dabonetn/Swift-Internal/readme.txt

I've moved the internal modems under the main Link-232-Wifi project.

Please see here.

https://github.com/dabonetn/Link232-Wifi
