dabonetn/Swift-Internal/Eagle/SF232-Internal-128 - Ver1.3/Swiftl1.3.png

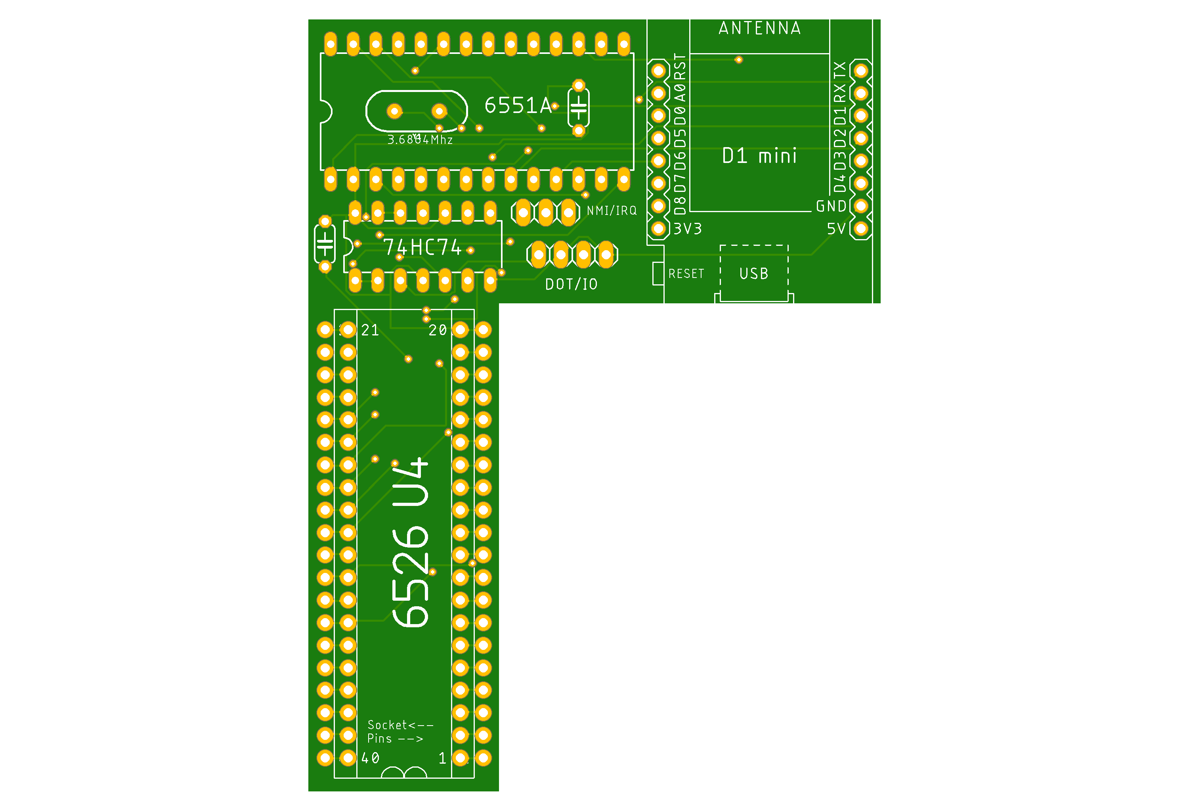
Eagle/SF232-Internal-128 - Ver1.3/Swiftl1.3.png
