dabonetn/Swift-Internal/Eagle/SF232-Internal-128 - Ver1.3/Link232-wifi.brd

## EAGLE design Eagle/SF232-Internal-128 - Ver1.3/Link232-wifi.brd (2022-05-11)

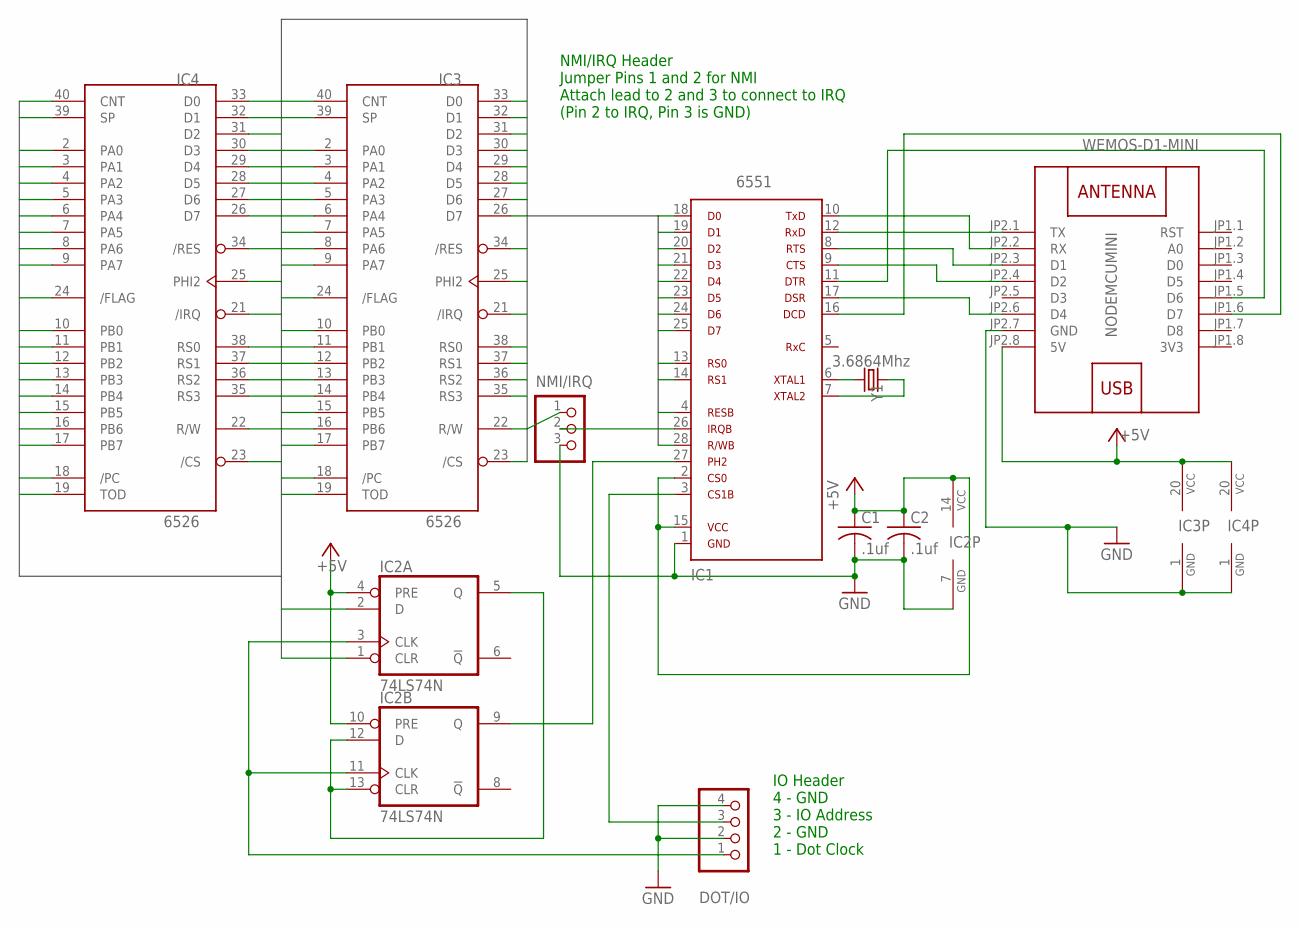
[picture p2: schematic Link232-wifi.sch]

Parts:
C1, C2: .1uf; C050-024X044
DOT/IO: PINHD-1X4; 1X04
IC1: 6551
IC2: 74LS74N; DIL14
IC3, IC4: 6526; DIP40
JP1: NMI/IRQ; 1X03
NODEMCUMINI: WEMOS-D1-MINI
Y1: 3.6864Mhz; HC49US

Connections:
3V3: NODEMCUMINI.JP1.8 (3V3)
+5V: C1.1, C2.1, IC1.2, IC1.15, IC2.4 (PRE), IC2.10 (PRE), IC2.14 (VCC), IC3.20 (VCC), IC4.20 (VCC), NODEMCUMINI.JP2.8 (5V)
/CS: IC3.23 (/CS), IC4.23 (/CS)
/FLAG: IC3.24 (/FLAG), IC4.24 (/FLAG)
/PC: IC3.18 (/PC), IC4.18 (/PC)
CNT: IC3.40 (CNT), IC4.40 (CNT)
D0: IC1.18, IC3.33 (D0), IC4.33 (D0)
D1: IC1.19, IC3.32 (D1), IC4.32 (D1)
D2: IC1.20, IC3.31 (D2), IC4.31 (D2)
D3: IC1.21, IC3.30 (D3), IC4.30 (D3)
D4: IC1.22, IC3.29 (D4), IC4.29 (D4)
D5: IC1.23, IC3.28 (D5), IC4.28 (D5)
D6: IC1.24, IC3.27 (D6), IC4.27 (D6)
D7: IC1.25, IC3.26 (D7), IC4.26 (D7)
GND: C1.2, C2.2, DOT/IO.2, DOT/IO.4, IC1.1, IC2.7 (GND), IC3.1 (GND), IC4.1 (GND), JP1.3, NODEMCUMINI.JP2.7 (GND)
IRQ: IC3.21 (/IRQ), IC4.21 (/IRQ), JP1.1
unnamed: DOT/IO.1, IC2.3 (CLK), IC2.11 (CLK)
unnamed: IC2.5 (Q), IC2.12 (D), IC2.13 (CLR)
unnamed: IC1.27, IC2.9 (Q)
unnamed: IC1.26, JP1.2
unnamed: DOT/IO.3, IC1.3
unnamed: IC1.6, Y1.2
unnamed: IC1.7, Y1.1
unnamed: IC1.12, NODEMCUMINI.JP2.1 (TX)
unnamed: IC1.10, NODEMCUMINI.JP2.2 (RX)
unnamed: IC1.8, NODEMCUMINI.JP2.3 (D1)
unnamed: IC1.9, NODEMCUMINI.JP2.4 (D2)
unnamed: IC1.17, NODEMCUMINI.JP2.6 (D4)
unnamed: IC1.11, NODEMCUMINI.JP1.5 (D6)
unnamed: IC1.16, NODEMCUMINI.JP1.6 (D7)
PA0: IC3.2 (PA0), IC4.2 (PA0)
PA1: IC3.3 (PA1), IC4.3 (PA1)
PA2: IC3.4 (PA2), IC4.4 (PA2)
PA3: IC3.5 (PA3), IC4.5 (PA3)
PA4: IC3.6 (PA4), IC4.6 (PA4)
PA5: IC3.7 (PA5), IC4.7 (PA5)
PA6: IC3.8 (PA6), IC4.8 (PA6)
PA7: IC3.9 (PA7), IC4.9 (PA7)
PB0: IC3.10 (PB0), IC4.10 (PB0)
PB1: IC3.11 (PB1), IC4.11 (PB1)
PB2: IC3.12 (PB2), IC4.12 (PB2)
PB3: IC3.13 (PB3), IC4.13 (PB3)
PB4: IC3.14 (PB4), IC4.14 (PB4)
PB5: IC3.15 (PB5), IC4.15 (PB5)
PB6: IC3.16 (PB6), IC4.16 (PB6)
PB7: IC3.17 (PB7), IC4.17 (PB7)
PHI2: IC2.1 (CLR), IC2.2 (D), IC3.25 (PHI2), IC4.25 (PHI2)
RES: IC1.4, IC3.34 (/RES), IC4.34 (/RES)
RS0: IC1.13, IC3.38 (RS0), IC4.38 (RS0)
RS1: IC1.14, IC3.37 (RS1), IC4.37 (RS1)
RS2: IC3.36 (RS2), IC4.36 (RS2)
RS3: IC3.35 (RS3), IC4.35 (RS3)
RW: IC1.28, IC3.22 (R/W), IC4.22 (R/W)
SP: IC3.39 (SP), IC4.39 (SP)
TOD: IC3.19 (TOD), IC4.19 (TOD)

Notes on the sheet:
IO Header 4 - GND 3 - IO Address 2 - GND 1 - Dot Clock
NMI/IRQ Header Jumper Pins 1 and 2 for NMI Attach lead to 2 and 3 to connect to IRQ (Pin 2 to IRQ, Pin 3 is GND)

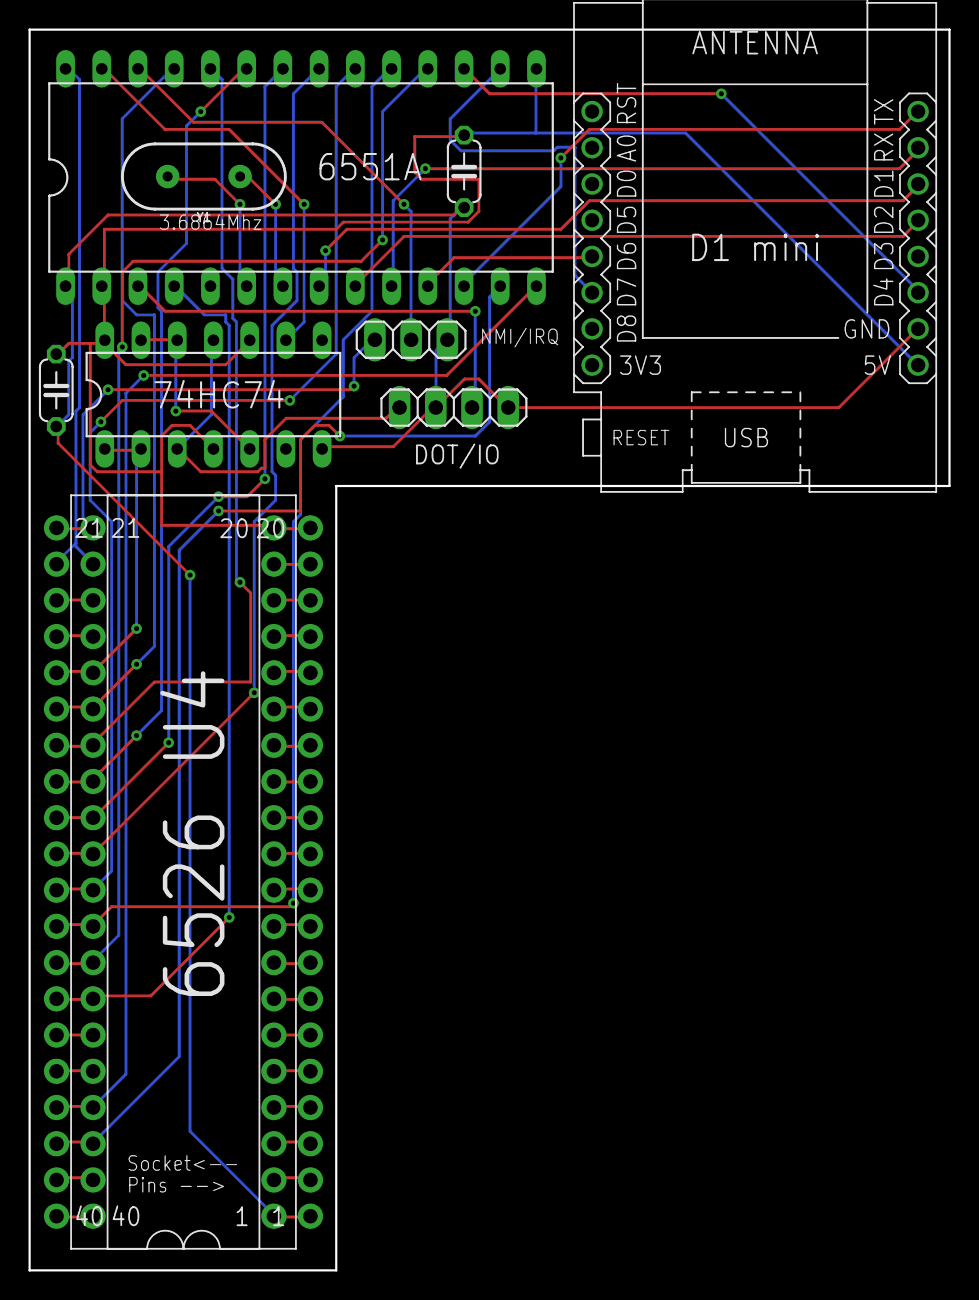
[picture p3: board Link232-wifi.brd from above]

Board: 2 copper layers, 64.5 x 87.0 mm, 10 parts (0 on the bottom side), 54 nets.
