dabonetn/Swift-Internal/Eagle/D700 Decoder/d700 decoder.brd

## EAGLE design Eagle/D700 Decoder/d700 decoder.brd (2020-07-10)

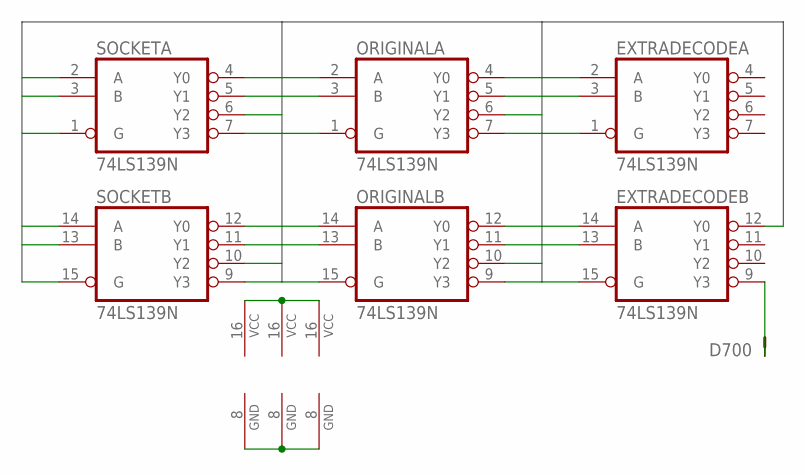
[picture p4: schematic d700 decoder.sch]

Parts:
D700: TP; JP1
EXTRADECODE: 74LS139N; DIL16
ORIGINAL: 74LS139N; DIL16
SOCKET: 74LS139N; DIL16

Connections:
A(2): EXTRADECODE.2 (A), ORIGINAL.2 (A), SOCKET.2 (A)
A(14): EXTRADECODE.14 (A), ORIGINAL.14 (A), SOCKET.14 (A)
B(3): EXTRADECODE.3 (B), ORIGINAL.3 (B), SOCKET.3 (B)
B(13): EXTRADECODE.13 (B), ORIGINAL.13 (B), SOCKET.13 (B)
G(1): EXTRADECODE.1 (G), ORIGINAL.1 (G), SOCKET.1 (G)
G(15): ORIGINAL.15 (G), SOCKET.15 (G)
GND: EXTRADECODE.8 (GND), ORIGINAL.8 (GND), SOCKET.8 (GND)
unnamed: D700.1, EXTRADECODE.9 (Y3)
SIDINTERNAL: EXTRADECODE.15 (G), ORIGINAL.5 (Y1)
VCC: EXTRADECODE.16 (VCC), ORIGINAL.16 (VCC), SOCKET.16 (VCC)
Y0(4-VICOUT): ORIGINAL.4 (Y0), SOCKET.4 (Y0)
Y0(12): ORIGINAL.12 (Y0), SOCKET.12 (Y0)
Y1(5-SIDOUT): EXTRADECODE.12 (Y0), SOCKET.5 (Y1)
Y1(11): ORIGINAL.11 (Y1), SOCKET.11 (Y1)
Y2(6): ORIGINAL.6 (Y2), SOCKET.6 (Y2)
Y2(10): ORIGINAL.10 (Y2), SOCKET.10 (Y2)
Y3(7): ORIGINAL.7 (Y3), SOCKET.7 (Y3)
Y3(9): ORIGINAL.9 (Y3), SOCKET.9 (Y3)

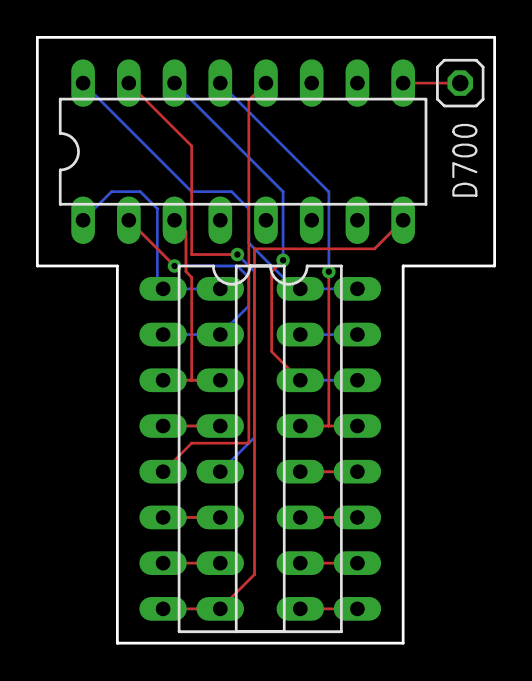
[picture p5: board d700 decoder.brd from above]

Board: 2 copper layers, 25.4 x 33.7 mm, 4 parts (0 on the bottom side), 18 nets.
