dabonetn/Swift-Internal/QuickInstallGuides/Swift-T.docx

Swift-T Quick install guide for the Commodore 64 Longboards.

Start by removing the CIA chip at U2.

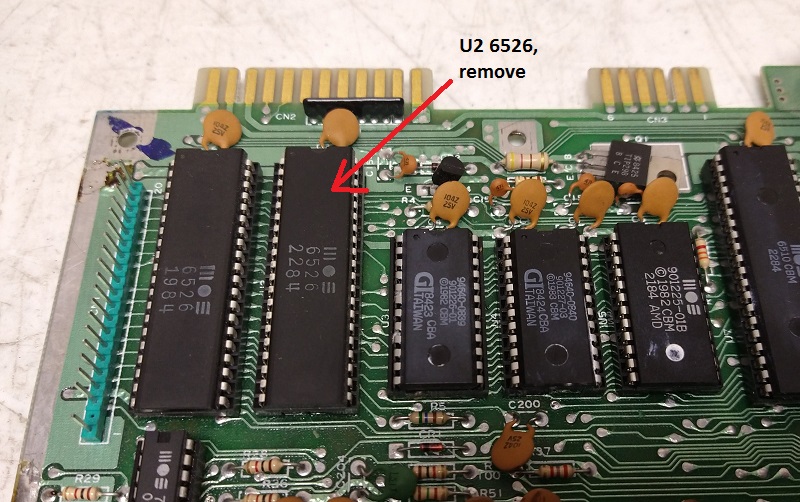
[picture p12: figure]

After removing the chip, insert the swift-t into the socket, wifi module to the rear of the machine.

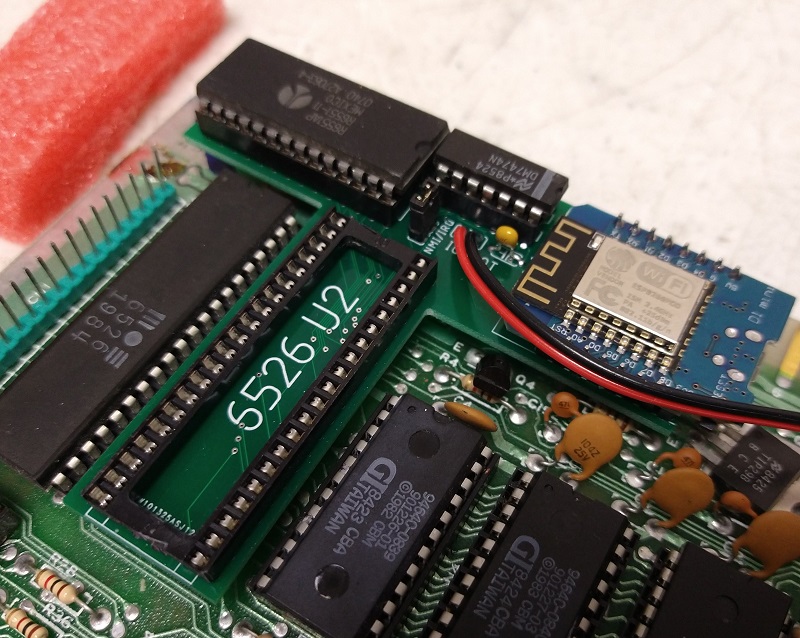
[picture p13: figure]

Next plug your original cia chip into the socket on the Swift-T. Notch goes towards the rear of the machine.

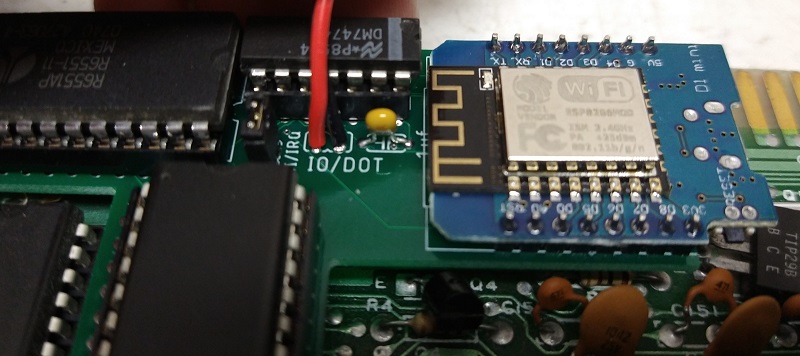
[picture p14: figure]

Now double check which wire is which. In the example, Red goes to the IO select pin, and black goes to DOT Clock.

Dot Clock ALWAYS goes to pin 6 on the cartridge port. This is the same on the 64 or the 128.


Now we need to pick a IO address for the Swiftlink Driver to use.

On the cartridge port, Pin 7 = DE00, and Pin 10=DF00

Here’s a example of DE00.


And here we have DF00.


For D700 addressing you need to remove and socket U15, this is usually located to the right of the ram chips.

Then install the option D700 adapter board, and connect the lead to the D700 header pin.

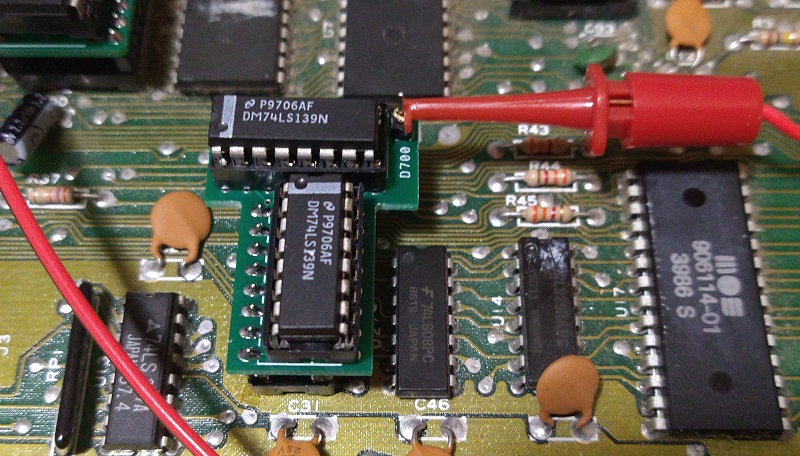
[picture p15: figure]

And that’s it, you are ready to load up your favorite terminal.

If you must have IRQ instead of NMI, you will need to remove the IRQ/NMI jumper from the Swift-T, and the run a lead (Not provided) to pin 21 of the other CIA chip.
