dabonetn/Swift-Internal/(threads)

Thread 1 (2021-01-29):

PCB options for PCBWay order?

mczero80, 2021-01-29:
Hi,

I have a question, which pcb size is correct for PCBWay and which other order options do you recommend?

Thank you!

dabonetn, 2021-01-29:
Since it's not a cartridge, just the standard thickness is fine. It's just a basic PCB.
No need for gold, or any other add ons.
Also look at Jlcpcb, they are really cheap also.

mczero80, 2021-01-30:
Ahh cool didn't now that manufacturer.

Good project, I am curious how it will turn out, especially the C128 version :)

Closed 2022-04-03.
