dabonetn/Swift-Internal/(commit log)

2020-07-10 Inital Commit.
    Inital Commit.
    [Link232-wifi-c64.brd, Link232-wifi-c64.sch, Link232-wifi.brd, Link232-wifi.sch, d700 decoder.brd, d700 decoder.sch]
2020-08-12 Update and bugfix for zimodem
    Fixed DCD not raising on manual answer. Fixed NO CARRIER being cut off to NO.
    [zimodem.ino]
2022-05-11 Board revision 1.3 Added
    [Link232-wifi.brd, Link232-wifi.sch]
